Robcib-GIT/PETER/Code_python/Tools/IK/PETER_workspace.png

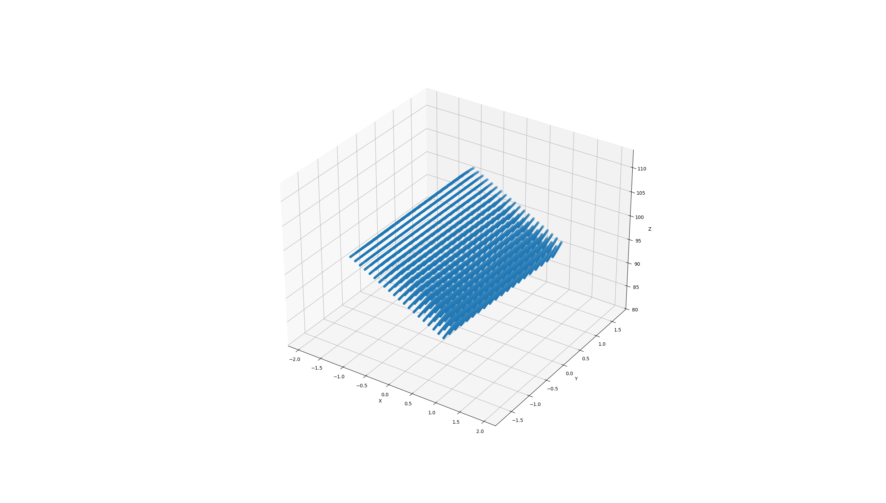
Code_python/Tools/IK/PETER_workspace.png
