Robcib-GIT/PETER/Code_python/Tools/red-circle/grid.jpg

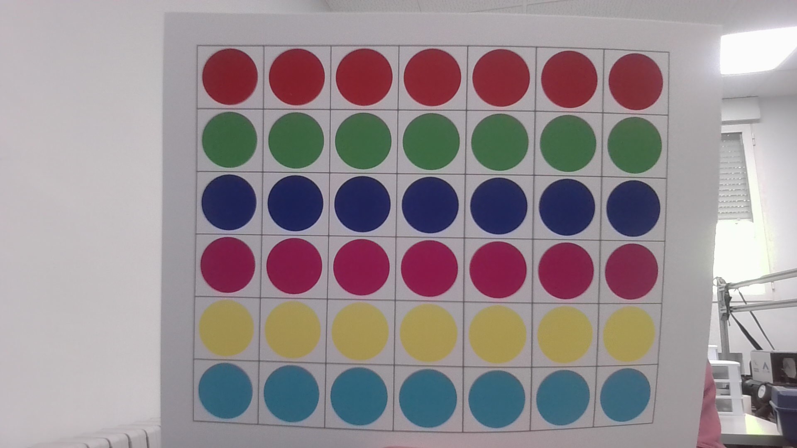
Code_python/Tools/red-circle/grid.jpg
