Robcib-GIT/PETER/Code_python/Tools/red-circle/videos/0-down.png

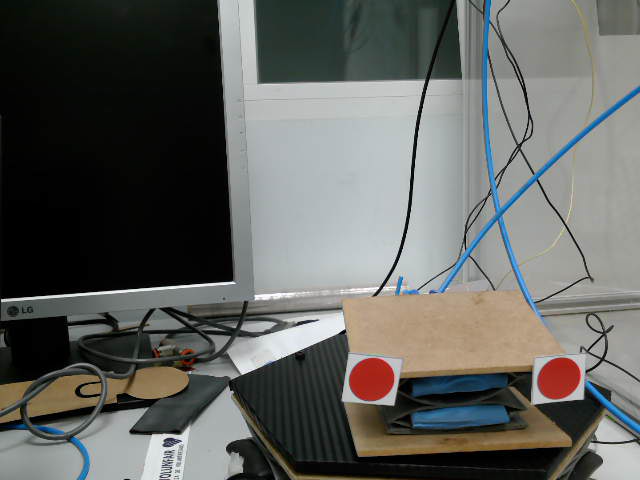
Code_python/Tools/red-circle/videos/0-down.png
