Robcib-GIT/PETER/Code_python/Tools/red-circle/videos/img1.jpg

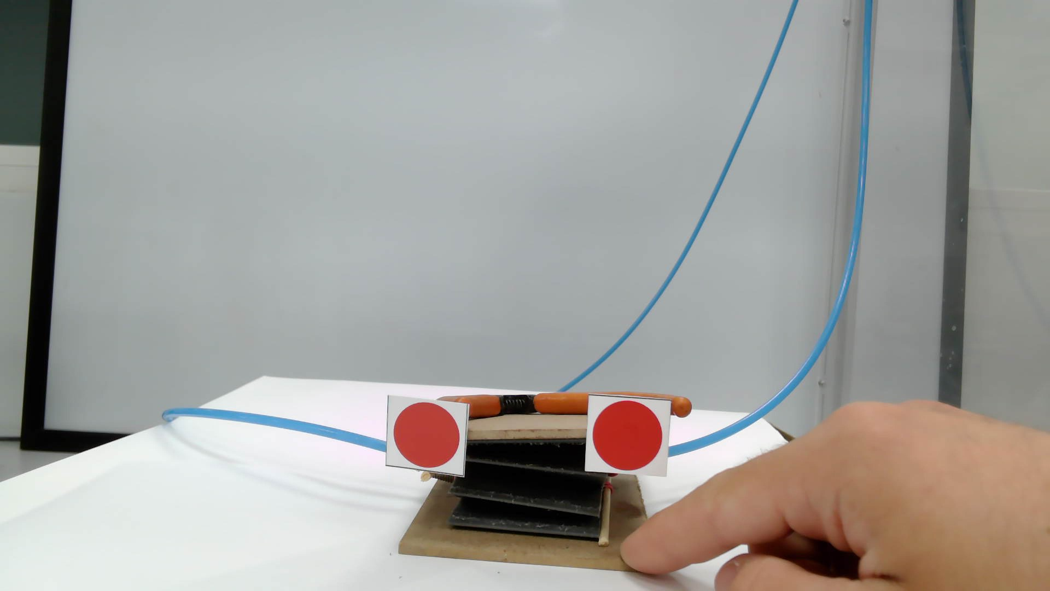
Code_python/Tools/red-circle/videos/img1.jpg
