Robcib-GIT/PETER/Code_python/Tools/red-circle/videos/img2.jpg

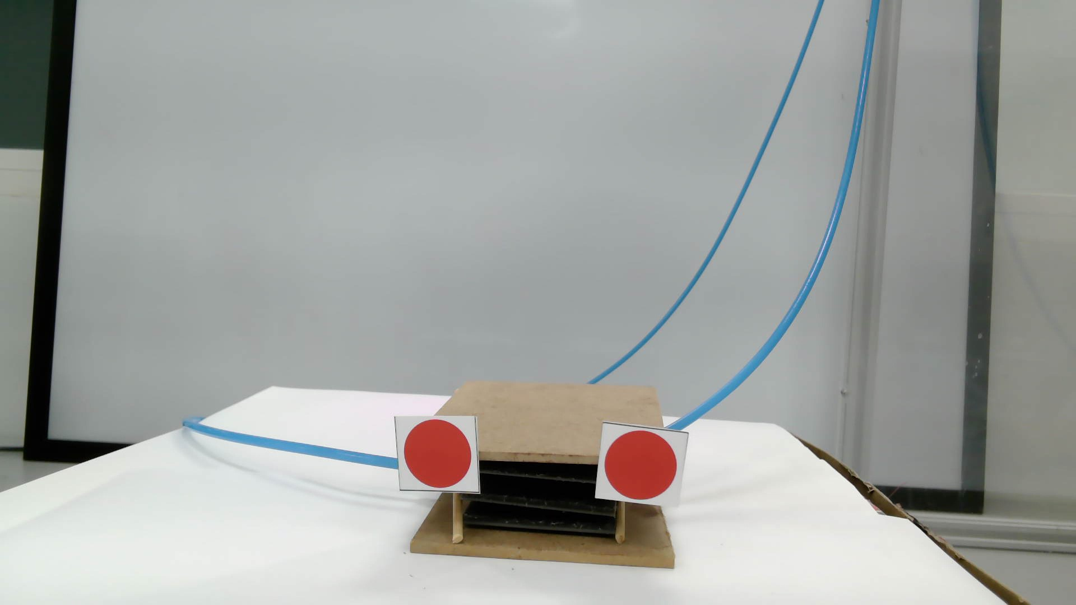
Code_python/Tools/red-circle/videos/img2.jpg
