Robcib-GIT/PETER/Code_python/Tools/red-circle/videos/img4.jpg

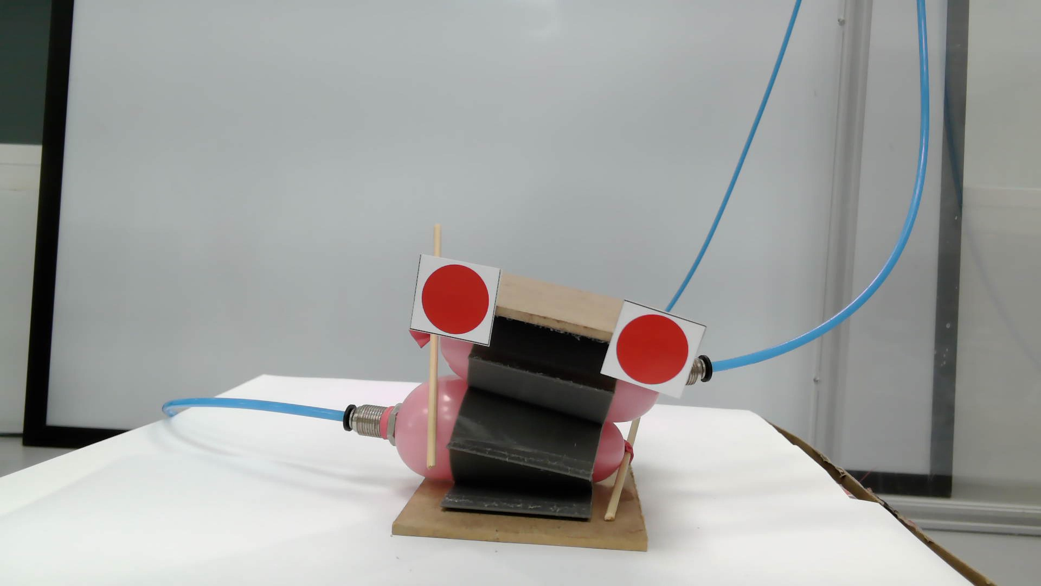
Code_python/Tools/red-circle/videos/img4.jpg
