Robcib-GIT/PETER/STL/module.stl

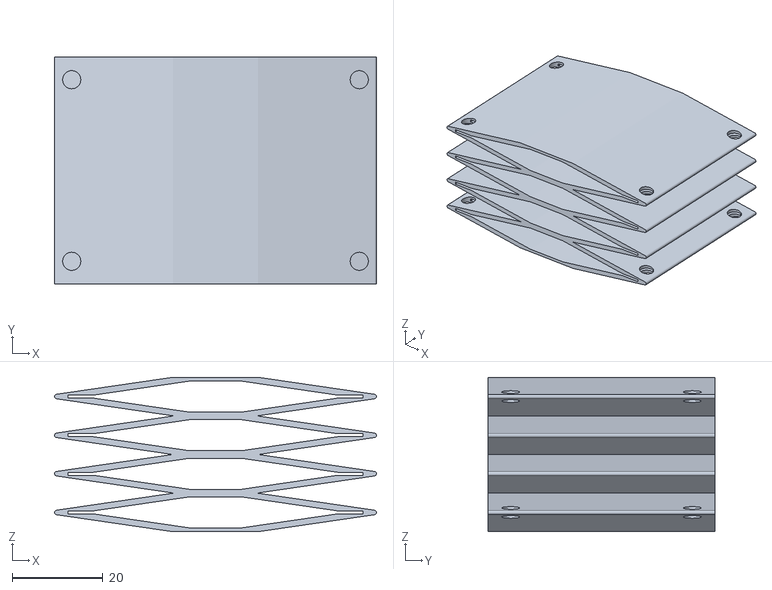
[picture p13: CAD file, 2024-07-24]
STL/module.stl
70.9 x 50.0 x 34.0
