Robcib-GIT/PETER/code_matlab/Validation/optitrack_test_data_1_xy.csv

X_est | Y_est | X_mes | Y_mes
-0.579780944 | -1.262437295 | 0 | 0
-0.629692428 | -1.254415613 | -0.057697296 | 0.192523003
-0.877940488 | -1.247176532 | 0.020742416 | 0.072598457
-1.047293025 | -1.259330727 | 0.089883804 | 0.206649303
-1.085520725 | -1.287876833 | 0.078678131 | 0.193595886
-0.722904495 | -1.239573109 | 0.024557114 | -0.027298927
-1.01915811 | -1.262372169 | 0.065207481 | 0.212669373
-1.084074213 | -1.247873684 | 0.092625618 | 0.155210495
-1.042911497 | -1.251980007 | 0.090718269 | 0.127494335
-0.718364318 | -1.236842667 | 0.018000603 | -0.123977661
-0.762158725 | -1.231046088 | -0.010848045 | 0.048875809
-0.784639707 | -1.254109143 | -0.027060509 | 0.029981136
-0.753626851 | -1.249121973 | 0.010251999 | -0.137627125
-0.603336333 | -1.211990897 | 0.008821487 | -0.111222267
-0.675889692 | -1.238028152 | -0.023603439 | -0.091671944
-0.72579583 | -1.24292039 | -0.007152557 | -0.070691109
-0.572739024 | -1.212859917 | -0.008106232 | -0.045418739
-0.785262074 | -1.241329291 | -0.01513958 | 0.110626221
-0.334995954 | -1.200318151 | -0.252485275 | 0.069618225
-0.712801316 | -1.219507836 | 0.023365021 | -0.018954277
-0.873829965 | -1.499096546 | -0.042319298 | 0.217437744
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
