Robcib-GIT/PETER/code_matlab/Validation/optitrack_test_data_1.csv

X_mm | Y_mm | Z_mm | Pitch_deg | Roll_deg | Yaw_deg
1306.3372373580933 | 727.5331616401672 | 875.899612903595 | 0.6697686908337134 | -0.307584821395906 | 0.26486307326171643
1306.2795400619507 | 727.7256846427917 | 875.8694529533386 | 0.6655373467714598 | -0.3340756046220939 | 0.38409895549250567
1306.357979774475 | 727.6057600975037 | 875.7743239402771 | 0.6617789419630792 | -0.4658336590966597 | 0.3003390119132981
1306.4271211624146 | 727.7398109436035 | 875.7020831108093 | 0.668292989704034 | -0.5557402465783683 | 0.4050142110257504
1306.4159154891968 | 727.7267575263977 | 875.6752610206604 | 0.6834656793196157 | -0.5760438795761701 | 0.4029996898158277
1306.3617944717407 | 727.5058627128601 | 875.8311867713928 | 0.6576945153484101 | -0.3835455729241769 | 0.2603977396620292
1306.4024448394775 | 727.7458310127258 | 875.6997585296631 | 0.6699071831592599 | -0.5408115960517137 | 0.4068760418050186
1306.4298629760742 | 727.6883721351624 | 875.7128715515137 | 0.6622068400653408 | -0.5752515378479087 | 0.38551585512588066
1306.4279556274414 | 727.6606559753418 | 875.7156729698181 | 0.6643814120350763 | -0.5534065521280401 | 0.40143471699640376
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
