Robcib-GIT/PETER/Code_python/Tools/length_test/2024-09-24-data-filters.csv

VL53L0X test | Each5 | Each10
75
72
74
72
71 | 72.8
75 | 72.8
72 | 72.8
74 | 72.8
72 | 72.8 | 73
76 | 73.8 | 73.11111111
72 | 73.2 | 73.11111111
71 | 73 | 72.77777778
76 | 73.4 | 73.22222222
70 | 73 | 73.11111111
73 | 72.4 | 72.88888889
73 | 72.6 | 73
74 | 73.2 | 73
74 | 72.8 | 73.22222222
74 | 73.6 | 73
73 | 73.6 | 73.11111111
70 | 73 | 73
74 | 73 | 72.77777778
75 | 73.2 | 73.33333333
74 | 73.2 | 73.44444444
72 | 73 | 73.33333333
69 | 72.8 | 72.77777778
75 | 73 | 72.88888889
75 | 73 | 73
71 | 72.4 | 72.77777778
72 | 72.4 | 73
68 | 72.2 | 72.33333333
69 | 71 | 71.66666667
76 | 71.2 | 71.88888889
72 | 71.4 | 71.88888889
76 | 72.2 | 72.66666667
74 | 73.4 | 72.55555556
75 | 74.6 | 72.55555556
76 | 74.6 | 73.11111111
72 | 74.6 | 73.11111111
69 | 73.2 | 73.22222222
71 | 72.6 | 73.44444444
76 | 72.8 | 73.44444444
70 | 71.6 | 73.22222222
74 | 72 | 73
72 | 72.6 | 72.77777778
76 | 73.6 | 72.88888889
70 | 72.4 | 72.22222222
72 | 72.8 | 72.22222222
73 | 72.6 | 72.66666667
71 | 72.4 | 72.66666667
75 | 72.2 | 72.55555556
71 | 72.4 | 72.66666667
72 | 72.4 | 72.44444444
71 | 72 | 72.33333333
74 | 72.6 | 72.11111111
73 | 72.2 | 72.44444444
71 | 72.2 | 72.33333333
74 | 72.6 | 72.44444444
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
