Robcib-GIT/PETER/Code_python/Tools/length_test/2024-09-24-data.csv

VL53L0X test
75
72
74
72
71
75
72
74
72
76
72
71
76
70
73
73
74
74
74
73
70
74
75
74
72
69
75
75
71
72
68
69
76
72
76
74
75
76
72
69
71
76
70
74
72
76
70
72
73
71
75
71
72
71
74
73
71
74
71
71
72
73
74
71
75
75
76
70
76
73
76
69
68
73
72
76
73
74
72
72
74
76
72
75
72
75
69
75
73
75
77
71
75
71
74
70
71
73
73
77
74
74
75
73
76
73
75
74
72
73
79
72
71
75
72
75
71
74
73
73
73
72
74
72
72
74
70
69
72
71
74
75
76
74
76
71
73
73
72
73
71
75
70
74
72
73
75
72
73
75
71
74
77
71
73
72
75
75
73
73
73
74
70
71
76
74
71
71
72
71
71
74
72
72
76
73
73
72
75
72
77
74
73
71
70
72
73
74
74
74
78
72
72
71
69
71
73
72
72
72
71
74
71
73
73
75
74
77
74
74
74
79
72
73
74
75
74
73
75
71
74
73
69
72
78
75
74
73
71
73
75
71
69
74
75
77
75
74
72
72
76
69
74
75
71
70
72
74
70
75
75
74
71
75
71
71
72
73
73
74
70
70
70
75
72
71
75
72
71
71
75
70
70
78
75
69
73
70
74
78
71
73
72
78
72
75
75
76
73
72
74
74
71
74
73
74
72
79
77
70
77
71
71
76
70
76
72
72
77
72
75
77
73
76
72
79
72
75
74
71
70
70
76
75
71
74
75
75
75
75
74
71
72
71
73
72
70
71
73
75
73
71
73
71
76
75
78
75
72
67
71
73
73
72
71
77
71
74
73
67
72
74
74
74
77
73
73
70
75
71
72
72
73
76
74
74
75
72
74
74
75
76
78
72
72
71
72
73
74
75
75
74
74
75
75
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
