Robcib-GIT/PETER/Code_python/Tools/red-circle/results/0-up_heights.csv

3.720000000000000000e+02 | 3.740000000000000000e+02 | 2.200000000000000000e+01
5.620000000000000000e+02 | 3.760000000000000000e+02 | 2.200000000000000000e+01
