Robcib-GIT/PETER/Code_python/Tools/red-circle/results/Pliers_heights_filtered.csv

8.505000000000000000e+02
8.440000000000000000e+02
8.435000000000000000e+02
8.475000000000000000e+02
8.440000000000000000e+02
8.440000000000000000e+02
8.430000000000000000e+02
8.735000000000000000e+02
8.455000000000000000e+02
8.450000000000000000e+02
8.450000000000000000e+02
8.445000000000000000e+02
8.440000000000000000e+02
8.440000000000000000e+02
8.235000000000000000e+02
8.135000000000000000e+02
8.440000000000000000e+02
8.455000000000000000e+02
8.450000000000000000e+02
8.440000000000000000e+02
8.440000000000000000e+02
8.255000000000000000e+02
8.445000000000000000e+02
8.445000000000000000e+02
8.430000000000000000e+02
8.445000000000000000e+02
8.230000000000000000e+02
8.445000000000000000e+02
8.220000000000000000e+02
8.475000000000000000e+02
7.865000000000000000e+02
8.785000000000000000e+02
8.450000000000000000e+02
8.450000000000000000e+02
8.485000000000000000e+02
8.480000000000000000e+02
8.450000000000000000e+02
8.415000000000000000e+02
8.450000000000000000e+02
8.445000000000000000e+02
8.430000000000000000e+02
8.455000000000000000e+02
8.485000000000000000e+02
8.445000000000000000e+02
8.440000000000000000e+02
8.445000000000000000e+02
8.445000000000000000e+02
8.225000000000000000e+02
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
