Robcib-GIT/PETER/Code_python/Tools/red-circle/results/short_byg_heights.csv

7.535000000000000000e+02 | 3.465000000000000000e+02 | 5.829999923706054688e+01 | 1.031500000000000000e+03 | 6.575000000000000000e+02 | 5.609999847412109375e+01 | 1.301500000000000000e+03 | 3.515000000000000000e+02 | 5.940000152587890625e+01
7.555000000000000000e+02 | 3.475000000000000000e+02 | 5.940000152587890625e+01 | 1.029500000000000000e+03 | 6.545000000000000000e+02 | 5.829999923706054688e+01 | 1.294500000000000000e+03 | 3.655000000000000000e+02 | 5.940000152587890625e+01
7.555000000000000000e+02 | 3.485000000000000000e+02 | 5.940000152587890625e+01 | -1.000000000000000000e+00 | -1.000000000000000000e+00 | -1.000000000000000000e+00 | 1.308500000000000000e+03 | 3.495000000000000000e+02 | 5.609999847412109375e+01
7.555000000000000000e+02 | 3.485000000000000000e+02 | 5.940000152587890625e+01 | -1.000000000000000000e+00 | -1.000000000000000000e+00 | -1.000000000000000000e+00 | 1.295500000000000000e+03 | 3.685000000000000000e+02 | 5.829999923706054688e+01
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
