Robcib-GIT/PETER/Code_python/Tools/red-circle/results/test_ivonne_heights.csv

2.945000000000000000e+02 | 2.365000000000000000e+02
3.795000000000000000e+02 | 1.395000000000000000e+02
4.355000000000000000e+02 | 2.150000000000000000e+01
