Robcib-GIT/PETER/Code_python/Tools/red-circle/videos/test_ivonne.png

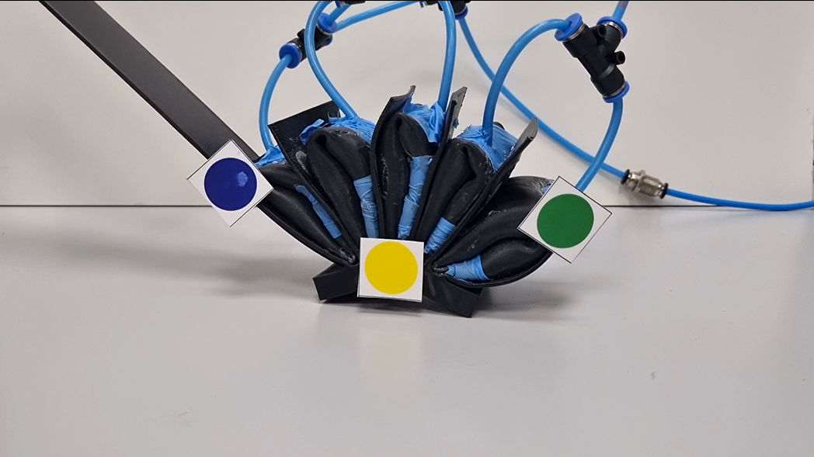
Code_python/Tools/red-circle/videos/test_ivonne.png
