Robcib-GIT/PETER/Code_arduino/Peter 4 Sensors measure/peter/Config.h

/*
  Program constants, type definitions...

  Jorge F. García-Samartín
  www.gsamartin.es
  2024-11-18
*/

#ifndef _CONFIG_H_
#define _CONFIG_H_

#include <Arduino.h>
#include <Wire.h>
#include <SPI.h>
#include <Adafruit_Sensor.h>
#include <Adafruit_BNO055.h>
#include <utility/imumaths.h>
#include "Pinout.h"

// 2 IMU 2 TOF
#define NUM_SENSORES 4

#define SCREEN_WIDTH 128 // OLED display width, in pixels
#define SCREEN_HEIGHT 64 // OLED display height, in pixels
#define SCREEN_ADDRESS 0x3C // OLED I2C address
#define OLED_RESET -1 // Reset pin # (or -1 if sharing Arduino reset pin)

enum modes
{
    S_NORMAL,
    S_ERROR_STOPAUTO,
    S_ERROR_EMERGENCY_STOP
};

const uint8_t LED_MAXV_R = 180;
const uint8_t LED_MAXV_G = 255;
const uint8_t LED_MAXV_B = 180;

#endif // _CONFIG_H_
