Robcib-GIT/PETER/(commit log)

2024-07-02 PCC IK and FK implemented!
    [OneStep_heights.csv, OneStep_heights_filtered.csv, Pliers_heights.csv, Pliers_heights_filtere_old.csv, Pliers_heights_filtered.csv, TwoSteps_heights.csv, TwoSteps_heights_filtered.csv, TwoSteps_heights_filtered_old.csv]
2024-07-24 IK 1 segment experiments completed
    [2024-07-05_durations.csv, 2024-07-05_iterations.csv, 2024-07-05_positions.csv, 2024-07-05_positions_references.csv, 2024-07-05_times.csv, 2024-07-08-19-03-55_durations.csv, 2024-07-08-19-03-55_iterations.csv, 2024-07-08-19-03-55_positions.csv]
2024-07-31 Repo cleaning
    [pos_time_dataset.csv]
2024-09-18 Arduino reorganisation to include Platformio
2024-09-30 Multiple colour circles detection
    [0-up_heights.csv, 2024-09-24-data-filters.csv, 2024-09-24-data.csv, short_byg_heights.csv, test_ivonne_heights.csv, video1_circles_for_angle.csv, video2_circles_for_angle.csv]
2024-10-02 Minor changes
    [video3_circles_for_angle.csv]
2024-10-04 Length-time tests
    [2024-09-24-data-filters.csv, 2024-09-24-data.csv, 2024-10-3_11-52-51_length-time.csv, 2024-10-3_12-37-20_length-time.csv, 2024-10-3_12-4-13_length-time.csv, 2024-10-3_12-40-28_length-time.csv, 2024-10-3_12-5-7_length-time.csv, 2024-10-3_12-58-57_length-time.csv]
2025-02-12 New dataset
    [pos_time_dataset.csv]
2025-04-02 Arduino code refactorisation
    [simulacion_random.csv]
2025-06-13 PETER software update
    [2025-06-12-peter_positions.csv, peter_positions.csv]
2025-06-16 Dynamic experiments
    [2025-06-12-peter_positions.csv, 2025-06-16-12-23-21-peter_positions.csv, 2025-06-16-12-24-53-peter_positions.csv, 2025-06-16-12-29-37-peter_positions.csv, 2025-06-16-12-30-45-peter_positions.csv, 2025-06-16-12-33-36-peter_positions.csv, 2025-06-16-12-34-11-peter_positions.csv, 2025-06-16-12-40-40-peter_positions.csv]
2025-07-01 Arduino Code Upload!
2025-07-15 Create I2C_scanner
2025-11-18 User Guide
    [optitrack_logger_alejandra_20251106_185253.csv]
2026-07-21 PETER Arduino code
    [optitrack_test_data_1_xy.csv]
2026-07-21 PETER Arduino code minor changes
